mage0r/Solder-Kits/Balloon/Images/balloon.dxf

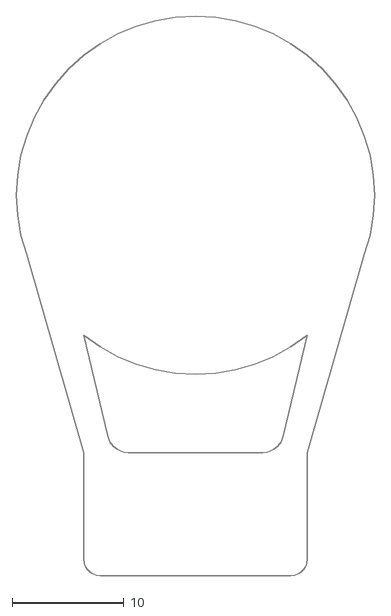
[picture p2: CAD file, 2018-02-20]
Balloon/Images/balloon.dxf
32.0 x 50.0
