mage0r/Solder-Kits/Buzzconf/Images/buzzconf.1.dxf

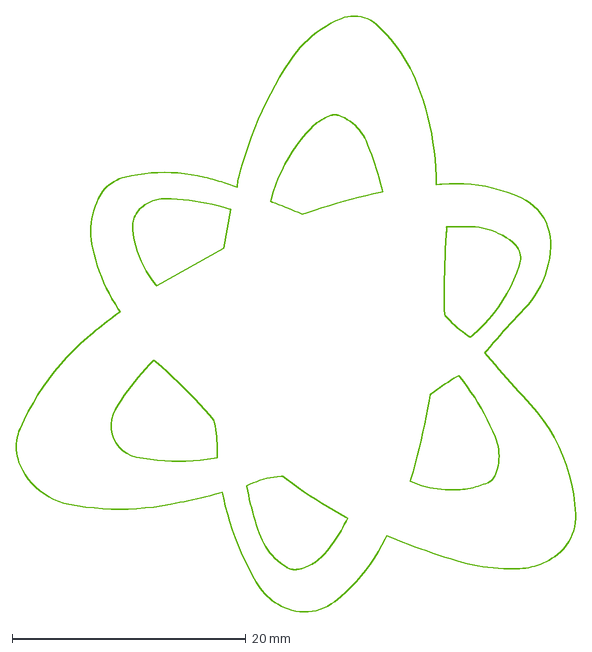
[picture p3: CAD file, 2018-02-20]
Buzzconf/Images/buzzconf.1.dxf
47.9 x 51.0 mm
