mage0r/Solder-Kits/(list of files, cad)

Other CAD files:
Balloon/Images/ballon-outline.skp
Buzzconf/Images/buzzconf.skp
Solder Rocket/Images/layout.skp
Solder Rocket/Images/rocket-outline.skp
