mage0r/Solder-Kits/Balloon/badge-kit.pdf

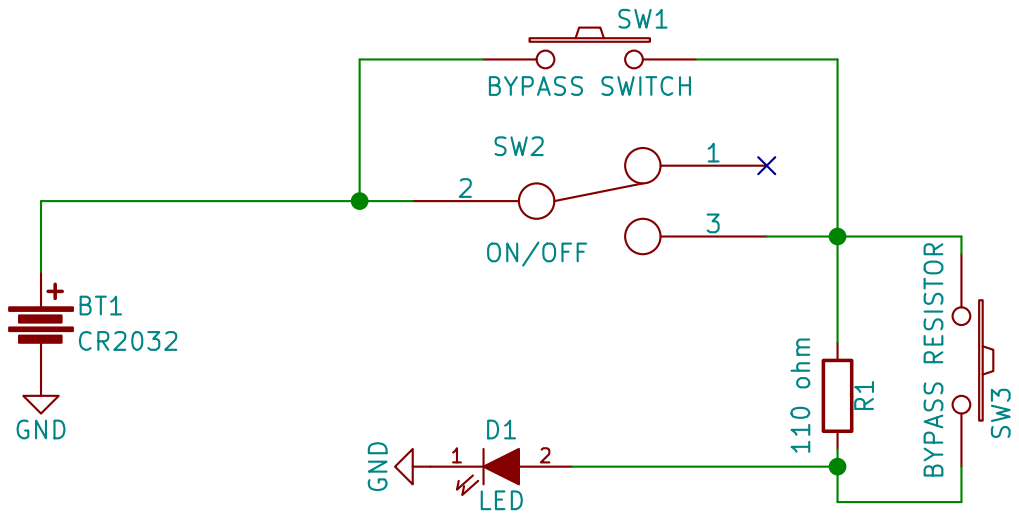
[picture p4: page 1]

File: badge-kit.sch Sheet: /
Id: 1/1 Title:
