mage0r/Solder-Kits/(list of files, drawings)

Other design files:
Balloon/badge-kit.dsn
Buzzconf/badge-kit.dsn
Coffs Harbour Rocket/badge-kit.dsn
