mage0r/Solder-Kits/Solder Rocket/README.md

Solder Rocket - How to solder kit.
=============

In the great tradition of hackerspaces everwhere, CCHS runs frequent, simple, "how to solder" courses for kids of all ages.

Our previous kit was designed by [Luke Weston](https://github.com/lukeweston/DIYBadgeKit) and had a very similar schematic.  This one has been updated for parts availability and in order to have a more "fun" board.

The "Rocket" outline was designed in Sketchup and exported as a dxf to be inputed in to KiCAD.

The "Solder Rocket" text was generated using simple text tools and imported using bitmap2component.

This updated design uses a metal battery holder.  This part does become hot during soldering but should cool quickly.

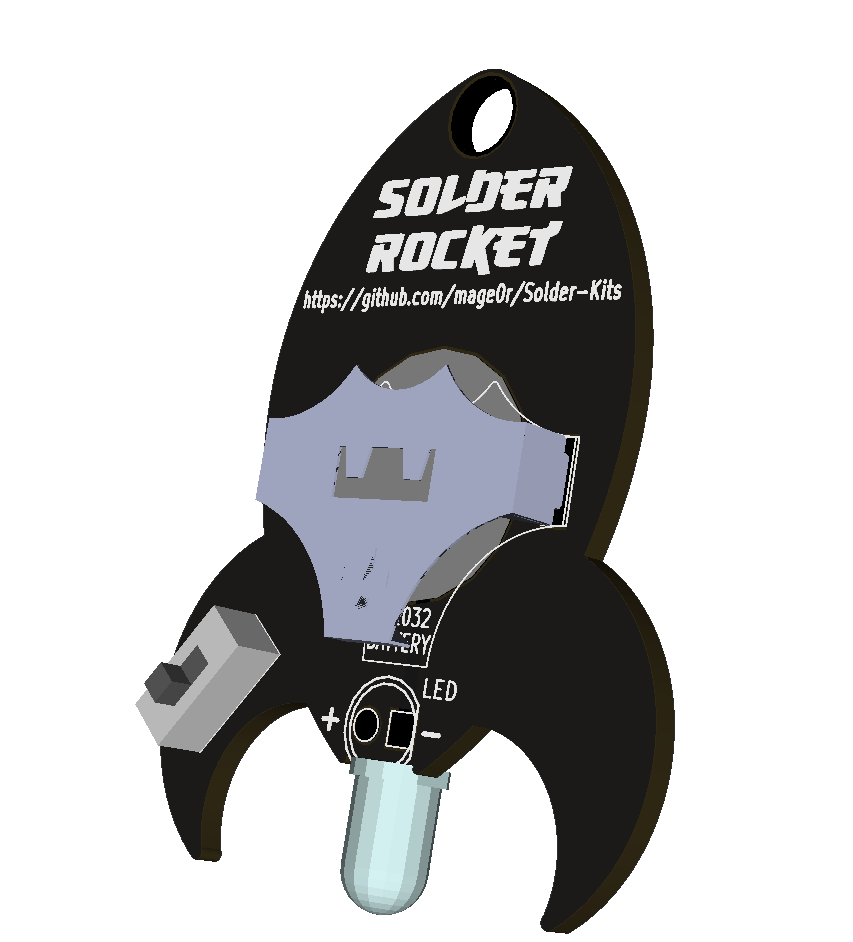
[picture p15: Solder Rocket/Images/badge-kit-3d.png]
Board Layout


BUY SOME!
------------

Tronixlabs is currently stocking these kits in packs of 3.

https://tronixlabs.com.au/kits/solder-rocket-learn-to-solder-kit-triple-pack-tronixlabs-australia/

CREDITS
------------

This project was designed by [John Spencer](https://github.com/mage0r)

ATTiny variant hacked together by [Robert Powers](https://github.com/rdpowers)

Made at hackmelbourne.org!

SPECIAL THANKS
------------

To the HackMelbourne (CCHS, http://hackmelbourne.org) community of Melbourne, Australia.

To all other open-source developers whose countless hours supported every other aspect of this design.

DISTRIBUTION
------------
The specific terms of distribution of this project are governed by the
license referenced below. Please contact the copyright owner if you wish to modify the board for distribution. Please utilize this design for personal or research projects. Please acknowledge all contributors.

LICENSE
-------
Licensed under the TAPR Open Hardware License (www.tapr.org/OHL).
A plain text version of this license is included in this directory.

Copyright John Spencer 2018
