mage0r/Solder-Kits/Coffs Harbour Rocket/Images/solder.rocket.jpg

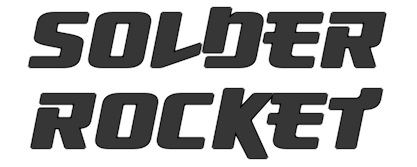
Coffs Harbour Rocket/Images/solder.rocket.jpg
