mage0r/Solder-Kits/Solder Rocket/Images/packaging.jpg

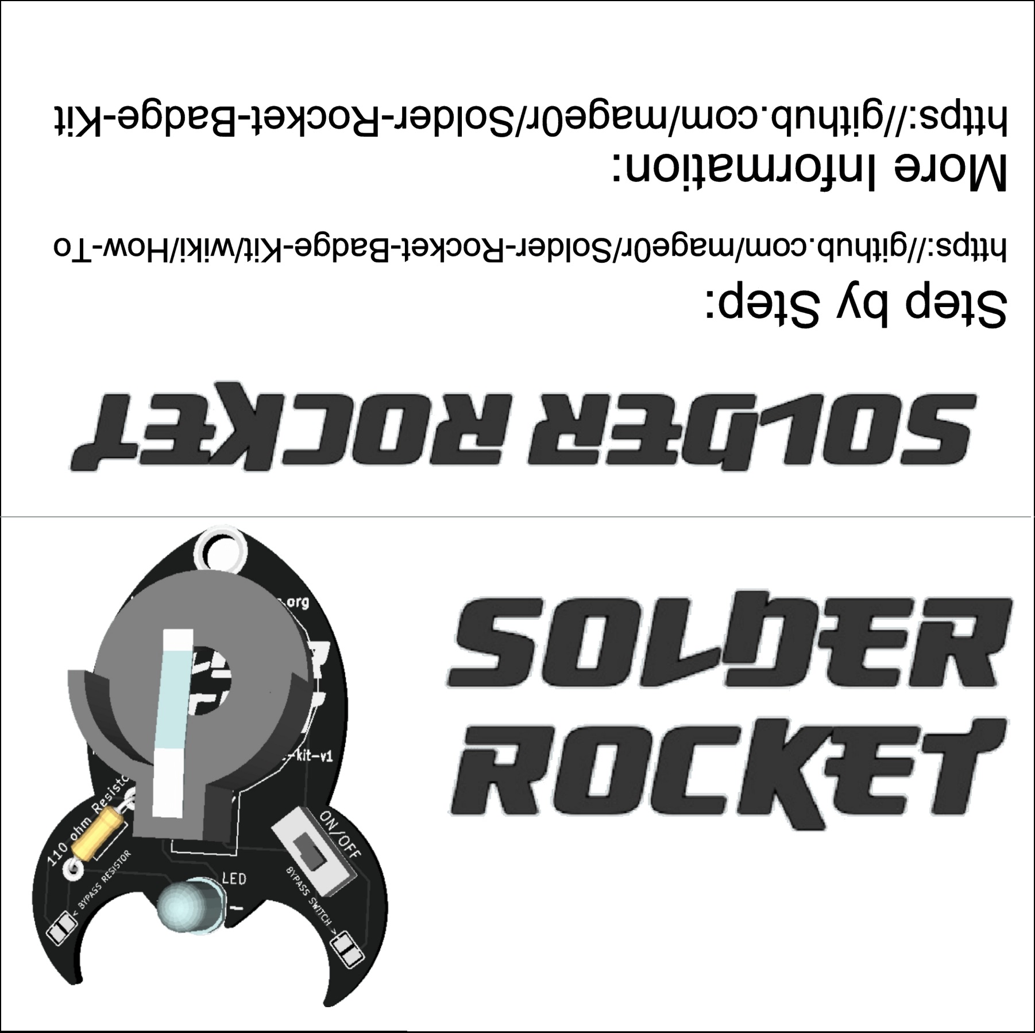
Solder Rocket/Images/packaging.jpg
