mage0r/Solder-Kits/(commit log)

2016-04-17 Initial Upload
    [badge-kit.dsn, badge-kit.kicad_pcb, badge-kit.sch, rocket-outline.dxf, rocket-outline.skp]
2016-05-24 Updated PCB
    [badge-kit.kicad_pcb]
2018-02-20 Move folder locations
    [badge-kit.dsn, badge-kit.kicad_pcb, badge-kit.sch, ballon-outline.skp, balloon.dxf, buzzconf.1.dxf, buzzconf.skp, rocket-outline.dxf]
2018-02-20 Adding packaging.
    [layout.skp]
2018-02-20 Coffs Harbour Hackerspace version
    [badge-kit.kicad_pcb, badge-kit.sch, rocket-outline.dxf]
2018-02-20 Updated design to version 1.7
    [badge-kit.kicad_pcb, badge-kit.sch, rocket-outline.dxf]
2018-03-09 Updated image
    [badge-kit.kicad_pcb]
2018-03-09 Moved folders aroudn
    Ok, this got messy.
    [badge-kit.dsn, badge-kit.kicad_pcb, badge-kit.sch, layout.skp, rocket-outline.dxf, rocket-outline.skp]
2018-03-09 man, that needs clean up
    [layout.skp, rocket-outline.dxf, rocket-outline.skp]
2018-05-29 Adding some library components for Solder Rocket ATTiny
2018-05-29 Changes to schematic
    [badge-kit.sch]
2018-05-29 Changes to PCB.
    [badge-kit.kicad_pcb]
2018-05-30 Fixed up LED footprint, pours, moved origin to something sensible.
    [badge-kit.kicad_pcb, badge-kit.sch]
2018-05-30 Attributions, other minor fixes.
    [badge-kit.kicad_pcb]
2018-05-30 Added Pin 1 to ICSP.
    [badge-kit.kicad_pcb]
2018-05-30 No idea, but OK.
    [badge-kit.kicad_pcb]
2018-05-30 Add mouting hole to PCB lib.
2018-05-30 Minor touches to PCB.
    [badge-kit.kicad_pcb]
2018-05-30 Some changes to gerber generation defaults.
    [badge-kit.kicad_pcb]
